FrikkieKritzinger/OmniTT/hardware/OmniTT Turntable Controller.kicad_pcb

## KiCad design hardware/OmniTT Turntable Controller.kicad_pcb (2026-11-02)

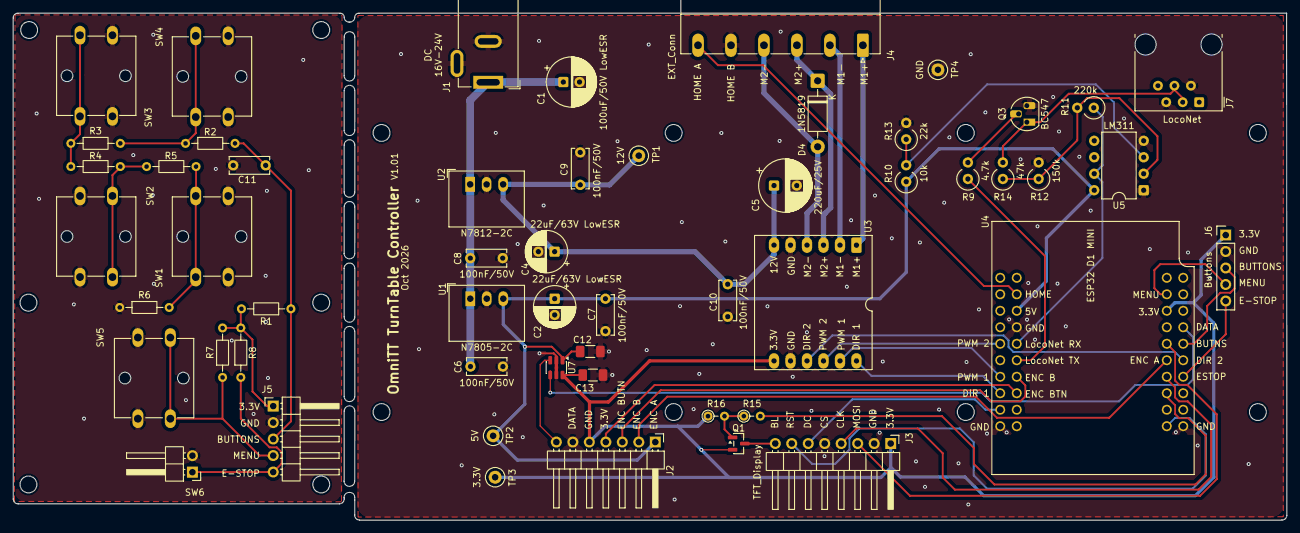
[picture p1: board OmniTT Turntable Controller.kicad_pcb from above]

Board: 2 copper layers, 196.2 x 78.1 mm, 54 parts (0 on the bottom side), 39 nets.

Parts:
C1: 100uF/50V LowESR; CP_Radial_D7.5mm_P2.50mm
C2, C4: 22uF/63V LowESR; CP_Radial_D6.3mm_P2.50mm
C5: 220uF/25V; CP_Radial_D8.0mm_P3.50mm
C6, C7, C8, C9, C10: 100nF/50V; C_Disc_D6.0mm_W2.5mm_P5.00mm
C11: 0.1uF Cer Disc; C_Disc_D6.0mm_W2.5mm_P5.00mm
C12, C13: 100nF/25V; C_1206_3216Metric_Pad1.33x1.80mm_HandSolder
D4: 1N5819; D_DO-41_SOD81_P10.16mm_Horizontal
J1: Barrel_Jack_Switch; BarrelJack_GCT_DCJ200-10-A_Horizontal
J2: Encoder+SW; PinHeader_1x07_P2.54mm_Horizontal
J3: TFT_Display; PinHeader_1x08_P2.54mm_Horizontal
J4: EXT_Conn; PhoenixContact_MC_1,5_6-G-5.08_1x06_P5.08mm_Horizontal
J5: Buttons_01x05_Pin; PinHeader_1x05_P2.54mm_Horizontal
J6: Buttons; PinHeader_1x05_P2.54mm_Vertical
J7: LocoNet; RJ12_Amphenol_54601-x06_Horizontal
Q1: Si2301CDS; SOT-23
Q3: BC547; TO-92L_HandSolder
R1: 1k; R_Axial_DIN0204_L3.6mm_D1.6mm_P7.62mm_Horizontal
R2, R4: 430R; R_Axial_DIN0204_L3.6mm_D1.6mm_P7.62mm_Horizontal
R3: 270R; R_Axial_DIN0204_L3.6mm_D1.6mm_P7.62mm_Horizontal
R5: 680R; R_Axial_DIN0204_L3.6mm_D1.6mm_P7.62mm_Horizontal
R6: 1.3k; R_Axial_DIN0204_L3.6mm_D1.6mm_P7.62mm_Horizontal
R7, R8: 10k; R_Axial_DIN0204_L3.6mm_D1.6mm_P7.62mm_Horizontal
R9: 4.7k; R_Axial_DIN0309_L9.0mm_D3.2mm_P2.54mm_Vertical
R10: 10k; R_Axial_DIN0309_L9.0mm_D3.2mm_P2.54mm_Vertical
R11: 220k; R_Axial_DIN0309_L9.0mm_D3.2mm_P2.54mm_Vertical
R12: 150k; R_Axial_DIN0309_L9.0mm_D3.2mm_P2.54mm_Vertical
R13: 22k; R_Axial_DIN0309_L9.0mm_D3.2mm_P2.54mm_Vertical
R14: 47k; R_Axial_DIN0309_L9.0mm_D3.2mm_P2.54mm_Vertical
R15: 100R; R_Axial_DIN0204_L3.6mm_D1.6mm_P2.54mm_Vertical
R16: 10k; R_Axial_DIN0204_L3.6mm_D1.6mm_P2.54mm_Vertical
SW1: SPEED; SW_SPST_Omron_B3F-50xx
SW2: LAST EXIT; SW_SPST_Omron_B3F-50xx
SW3: PRESET B; SW_SPST_Omron_B3F-50xx
SW4: PRESET A; SW_SPST_Omron_B3F-50xx
SW5: MENU; SW_SPST_Omron_B3F-50xx
SW6: E-STOP; PinHeader_1x02_P2.54mm_Horizontal
TP1: 12V; TestPoint_Loop_D1.80mm_Drill1.0mm_Beaded
TP2: 5V; TestPoint_Loop_D1.80mm_Drill1.0mm_Beaded
TP3: 3.3V; TestPoint_Loop_D1.80mm_Drill1.0mm_Beaded
TP4: GND; TestPoint_Loop_D1.80mm_Drill1.0mm_Beaded
U1: N7805-2C; Converter_DCDC_RECOM_R-78HB-0.5_THT
U2: N7812-2C; Converter_DCDC_RECOM_R-78HB-0.5_THT
U3: DFRobot TB6612FNB Module
U4: ESP32 D1 MINI; MODULE_TTGO_T7_MINI32_V1.3
U5: LM311; DIP-8_W7.62mm
U7: SN74LVC1T45DBV; SOT-23-6

Connections:
+3.3V: C13.2, J2.5, J3.1, J5.1 (3.3V), J6.1, Q1.2 (S), R1.2, R7.2, R8.2, R16.1, TP3.1 (1_1), U3.7 (VCC), U4.P1_16 (3V3), U7.6 (VCCB)
+5V: C2.1, C7.1, C12.1, J2.1, R10.1, TP2.1 (1_1), U1.3 (VO), U4.P2_15 (5V), U5.8 (V+), U7.1 (VCCA)
+12V: C4.1, C5.1, C9.2, C10.1, TP1.1 (1_1), U2.3 (VO), U3.6 (VM(<12V))
BL: J3.8, Q1.3 (D)
BUTTONS_ADC_IN: C11.2, J5.3 (BUTTONS_ADC_IN), J6.3, R1.1, R2.2, U4.P1_11 (GPIO34)
CLK: J3.4, U4.P1_8 (GPIO18)
DIR 1: U3.12 (DIR1), U4.P2_6 (GPIO25)
DIR 2: U3.9 (DIR2), U4.P1_9 (GPIO33)
D/C: J3.6, U4.P2_4 (GPIO27)
ENCODER A: J2.2, U4.P1_10 (GPIO19)
ENCODER B: J2.3, U4.P2_7 (GPIO21)
ENCODER BUTTON: J2.4, U4.P2_5 (GPIO22)
E_STOP: J5.5 (ESTOP), J6.5, R8.1, SW6.1, U4.P1_7 (GPIO35)
GND: C1.2, C2.2, C4.2, C5.2, C6.2, C7.2, C8.1, C9.1, C10.2, C11.1, C12.2, C13.1, J1.2, J1.3, J2.6, J3.2, J3.5, J4.5 (Home_SW_A), J5.2 (GND), J6.2, J7.2, J7.5, Q3.3 (E), R6.1, R12.2, R13.2, SW1.2, SW2.2, SW3.2, SW4.2, SW5.2, SW6.2, TP4.1 (1_1), U1.2 (GND), U2.2 (GND), U3.5 (GND), U3.8 (GND), U4.P1_1 (GND1_1), U4.P2_2 (GND2_2), U4.P2_13 (GND2_13), U5.1 (GND), U5.4 (V-), U7.2 (GND), U7.5 (DIR)
HOME: J4.6 (Home_SW_B), U4.P2_17 (TDO)
LN_IN (RX): R11.1, U4.P2_11 (GPIO16), U5.7
LN_OUT (TX): R9.1, U4.P2_9 (GPIO17)
M1 +: J4.1 (Motor_1_+), U3.1 (M1+)
M1 -: J4.2 (Motor_1_-), U3.2 (M1-)
M2 +: D4.1 (K), J4.3 (Motor_2_+), U3.3 (M2+)
M2 -: D4.2 (A), J4.4 (Motor_2_-), U3.4 (M2-)
MENU: J5.4 (MENU), J6.4, R7.1, SW5.1, U4.P1_18 (TCK)
MOSI: J3.3, U4.P1_12 (GPIO23)
NEOPIXEL DATA: U4.P1_13 (TMS), U7.4 (B)
unnamed: J2.7, U7.3 (A)
unnamed: Q1.1 (G), R15.1, R16.2
unnamed: Q3.2 (B), R9.2
unnamed: J7.3, J7.4, Q3.1 (C), R14.2
unnamed: R2.1, R3.2, SW4.1
unnamed: R3.1, R4.2, SW3.1
unnamed: R4.1, R5.2, SW2.1
unnamed: R5.1, R6.2, SW1.1
unnamed: C1.1, C6.1, C8.2, J1.1, U1.1 (VI), U2.1 (VI)
unnamed: R15.2, U4.P1_6 (GPIO26)
unnamed: R11.2, R12.1, R14.1, U5.2 (+)
unnamed: R10.2, R13.1, U5.3 (-)
PWM 1: U3.11 (PMW1), U4.P2_8 (GPIO32)
PWM 2: U3.10 (PWM2), U4.P2_12 (GPIO04)
RST: J3.7, U4.P1_2 (RST)
