FrikkieKritzinger/OmniTT/(commit log)

2026-10-07 Set up PlatformIO build system and project skeleton
    - platformio.ini: d1_mini (ESP8266) and native (host test) environments
    - src/: main.cpp skeleton, version.h, config.h with pin assignments and EEPROM layout
    - test/: Unity test framework setup, test_config.cpp placeholder
    - docs/BUILD.md: build commands, pin reference, memory baseline (RAM 34.4%, Flash 25.4%)
    - wifi_credentials.local.h.example: template for secrets (kept local/gitignored)
    Both firmware and test builds verified working. Ready for subsystem implementation.
2026-10-07 Resolve OI-01 and OI-11: ESP32 D1 Mini + 2.44" SPI OLED
    **OI-01 (Display):** Size priority. Use 2.44" SPI OLED (128×64) from stock,
    meeting 2.4" minimum. SPI frees I²C bus for sensors and is available on board.
    **OI-11 (GPIO Budget):** Upgrade from ESP8266 to ESP32 D1 Mini. Provides 30+
    usable GPIO, eliminates expander complexity, ensures future headroom. Form
    factor stays familiar (Wemos D1 Mini compatible).
    **Changes:**
    - SRD updated to v0.12: HW-01 targets ESP32, HW-10/11 reflect SPI OLED choice
    - Open issues OI-01 and OI-11 marked RESOLVED with decisions
    - config.h: GPIO pin assignments for ESP32 (15 pins used, 15+ free)
    - GPIO_REFERENCE.md: Complete pin map, strap pin analysis, usag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
    [config.h]
2026-10-07 Resolve OI-04, OI-05, OI-08/09: Motor control & position tracking (Fleischmann 6152)
    **OI-04 (Motor driver):** TB6612FNG Dual H-Bridge modules. 4 GPIO pins per module
    (2 direction, 2 PWM). Supports DC or stepper motors, up to 12V/1.2A.
    **OI-05 (Position tracking):** Time-based dead-reckoning via calibrated motor timing.
    Milliseconds per position learned and stored in "Index Hold Time" menu. Solenoid
    auto-locks at each index. First move after power-up recalibrates position.
    **OI-08/09 (Home detection & startup):** Microswitch at home position (GPIO35).
    Display flashing RED bridge icon from startup until first home pass. Once home is
    detected, position is set to HOME, icon turns GREEN, then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
    [config.h]
2026-10-11 Resolve OI-02 and OI-03: dedicated MENU and E-STOP buttons
    - MENU: dedicated push button for RUN/MENU switching; encoder stays for navigation with click feedback
    - E-STOP: dedicated push button among the six console buttons
    - Physical layout reworked for Sanhe 18-33 console enclosure (HW-30..32)
    - SRD v0.13; changelog updated
2026-10-11 Add status ring as planned feature (HW-16, RUN-30..33)
    - 12-pixel NeoPixel ring under the 35 mm knob, shown as a state indicator
    - States: red pulse (position unknown), amber (moving), green (locked/idle), solid red (E-stop)
    - SRD v0.14; changelog updated
2026-10-11 Add preset and last-exit shortcut buttons (RUN-40..43, CFG-11, DAT-05)
    - PRESET A/B recall stored exits; hold stores current exit (hold time CFG-11)
    - LAST EXIT returns to previous exit
    - Shortcut rules follow encoder selection (MD-05, HW-06)
    - Presets and last exit stored in EEPROM (DAT-05)
    - Accessory/layout control stated as out of scope
    - One button spare
    - SRD v0.15; changelog updated
2026-10-11 Resolve OI-06: web configuration mirrors the local menu (MNU-20..24)
    - Web config mirrors the menu; Wi-Fi password is write-only
    - AP and web service start on demand, stop on idle timeout or leaving menu
    - Calibration moves allowed from web when idle, not in MENU or E-stop; STOP offered
    - Admin PIN and home-network access deferred
    - SRD v0.16; changelog updated
2026-10-11 Resolve OI-07: extra config values and SPEED button (CFG-12..17, RUN-44, DAT-06)
    - Config: normal/rapid move speed, move timeout, ramp time, ring and OLED brightness
    - SPEED button toggles NORMAL/RAPID; RAPID is a hard lockout until position is determined
    - Mode persists across power cycles
    - All six console buttons assigned
    - Relay crossover angle deferred
    - SRD v0.17; changelog updated
2026-10-11 Resolve OI-10: position after power-up (RUN-22..24)
    - Interrupted move treated the same as an orderly restart; no move-in-progress flag
    - First move after power-up: operator-selected direction, run until home sensor is passed, then stop at target
    - Dead reckoning afterwards, re-confirmed at every home pass
    - SRD v0.18; changelog updated
2026-10-11 Resolve OI-12 and OI-13: solenoid on TB6612 channel B, no standby line
    - Motor on channel A, lock solenoid on channel B (both 12 V, few hundred mA)
    - DFRobot TB6612FNG board has no standby line; no GPIO needed
    - Motor/solenoid pins: DIR1 GPIO13, PWM1 GPIO32, DIR2 GPIO14, PWM2 GPIO4
    - PWM pins need external pull-downs for boot safety
    - New OI-14: pin budget and strapping pins
    - SRD v0.20; changelog updated
2026-10-11 Update CLAUDE.md: ESP32 target, status, phase plan and architecture
    - Target changed to ESP32 (D1 Mini form factor)
    - Phase 0 status and six-phase implementation plan
    - Module architecture table with host-testable split
2026-10-11 Finalise pin map (OI-14); defer relay to later phase
    - Initial build uses 21 pins; OLED CS hard-wired low, freeing GPIO5
    - Strapping pins used only where boot state is harmless (GPIO5 status ring, GPIO15 SPEED)
    - GPIO12 no longer used; GPIO0 and GPIO2 unused
    - Relay deferred to a later phase (HW-05, CFG-05); no relay pin in initial build
    - Removed stale I2C_ADDRESS_DISPLAY from config.h
    - GPIO_REFERENCE.md rewritten to match config.h
    - SRD v0.21; changelog updated
    [config.h]
2026-10-12 Update CLAUDE.md status: Phase 0 complete, pin map final
    - Phase 0 complete at SRD v0.21; OI-01..OI-14 resolved
    - Pin map finalised; GPIO_REFERENCE.md listed in file map
    - Next: Phase 1
2026-10-12 Verify board pins and reference them by silkscreen label
    - All planned outputs and inputs tested on the physical D1 ESP32 board
    - Labels used in GPIO_REFERENCE.md, config.h comments, SRD OI-08/12/14 and BUILD.md
    - BUILD.md pin list replaced (was the old ESP8266 plan)
    - Pull-up and pull-down guidance recorded in GPIO_REFERENCE.md
    - SRD v0.23; changelog updated
    [config.h]
2026-10-12 Add hardware to-do list to CLAUDE.md
    - TB6612FNG input pull-down check (multimeter, board unpowered)
    - Input reassignment to remove button and home-sensor pull-ups
    - OLED RES tie-high check; status ring level shifter
2026-10-12 Update hardware to-do from TB6612FNG datasheet review
    - Input pull-downs (200 kΩ internal) confirmed from datasheet pin table; meter check still open
    - VCC must be 3.3 V (operating 2.7 to 5.5 V); STBY active-low
    - Bypass caps per application circuit; flyback diode for solenoid to verify
2026-10-12 Add power and protection items to hardware to-do
    - Flyback diode across lock solenoid (1N4007 or UF4007)
    - Input filter caps for N7812-1PV and the D1 power shield
    - Open questions: -12 V rail use, 1 A headroom at stall
2026-10-12 Remove -12 V rail from N7812-1PV to-do
    The -12 V output is not used and is excluded from the documentation.
2026-10-12 Resolve OI-15: release rule, step-based timing and fastest-path moves
    - Only fitted index pieces are stops; exits stored as 7.5 degree step numbers (EXT-01)
    - Lock is passive; solenoid released mid-gap after previous index (RUN-25)
    - Motor keeps running until lock drops; PWM stops at expected arrival plus margin (RUN-26)
    - CFG-08 is calibrated time per step for NORMAL and RAPID, learned once (RUN-27)
    - Fastest path for all moves; first move counts from home pass (RUN-23, RUN-28)
    - SRD v0.25; CLAUDE.md open items updated
2026-10-14 Keep verified pin map; add pull-ups and DIR2 jumper to hardware to-do
    - Pin map unchanged; external 10 kΩ pull-ups on input-only pins 34, 35, SVP, SVN
    - DIR2 3-way jumper (pull-up, pull-down, GPIO14) to set solenoid direction and keep stepper option
2026-10-14 Finalise 18-pin map with resistor ladder for shortcut buttons
    - MENU on TCK, E-STOP on 35 (normally closed), home sensor on TDO
    - Four shortcut buttons share ADC pin 34 via resistor ladder (HW-17)
    - Motor DIR1 on 25, solenoid DIR2 on 33 (jumper); PWM unchanged
    - Status ring on TMS (14); only strapping pin in use is TDO
    - SRD v0.26; GPIO reference, BUILD.md, config.h and CLAUDE.md to-do updated
    [config.h]
2026-10-14 Switch display to Waveshare 2.0" IPS with backlight PWM on GPIO26
    - Display: Waveshare 2.0" IPS, 240x320, ST7789V (replaces 2.44" OLED notes)
    - CS tied to GND; RST on ESP32 RST line; backlight PWM from GPIO26 via MOSFET
    - CFG-17 is now software brightness (0 = off)
    - Pin map: 18 pins
    - SRD v0.28; GPIO reference, BUILD.md, config.h and CLAUDE.md updated
    - Open: HW-11 size is below the 2.4" minimum; backlight PWM needs a bench check
    [config.h]
2026-10-15 Move LocoNet to a later phase; series resistor ladder; 16-pin map
    - LocoNet requirements (HW-06, HW-20, RUN-11/13/14, 7.5, section 8) deferred
    - LocoNet pins 16 and 17 reserved, not assigned; initial build uses 16 pins
    - Shortcut button ladder changed to series string (430/270/430/680/1.3k, 1k top)
    - Button levels 992/1359/1755/2123 mV, no button 2497 mV, fault below 700 mV
    - SRD v0.30; GPIO reference, config.h, CLAUDE.md and changelog updated
    [config.h]
2026-10-15 Change E-STOP to normally open, active LOW
    - E-STOP is a normally open firmware input with a 10 kΩ pull-up (active LOW)
    - Main power switch is the backstop for a hung firmware
    - SRD v0.31; config.h, GPIO reference, CLAUDE.md and changelog updated
2026-10-15 Correct flash pin list in GPIO reference (SD0, SD1 not SDI, SDO)
2026-10-29 Changelog: verify schematic and PCB against the design (2026-10-29)
    Records the panel layout, the J5/J6 cable pinout, the button board
    ladder and pull-up wiring, the page 2 fixes (+3.3 V pin, global
    labels, ladder junctions), and the editor netlist to PCB check.
2026-11-02 Docs: TB6612 VCC at 3.3 V, STBY pull-up confirmed, session 8 review
2026-11-02 Docs: U3 VCC now on 3.3 V in schematic and board
2026-11-02 Add KiCad hardware project and ignore KiCad local state
    [OmniTT Turntable Controller.kicad_pcb, OmniTT Turntable Controller.kicad_sch, loconet_interface.kicad_sch, tt_control.kicad_sch]
2026-11-02 Add author's DFRobot TB6612 symbol and footprint with project library tables
